PeeJay/MotionBoard/README.md

# MotionBoard
FirePick Delta/Ramps compatible motion controller running Smoothie
