PeeJay/MotionBoard/MotionBoard Rev C.pdf

## UART0 (Also for ISP Loading)

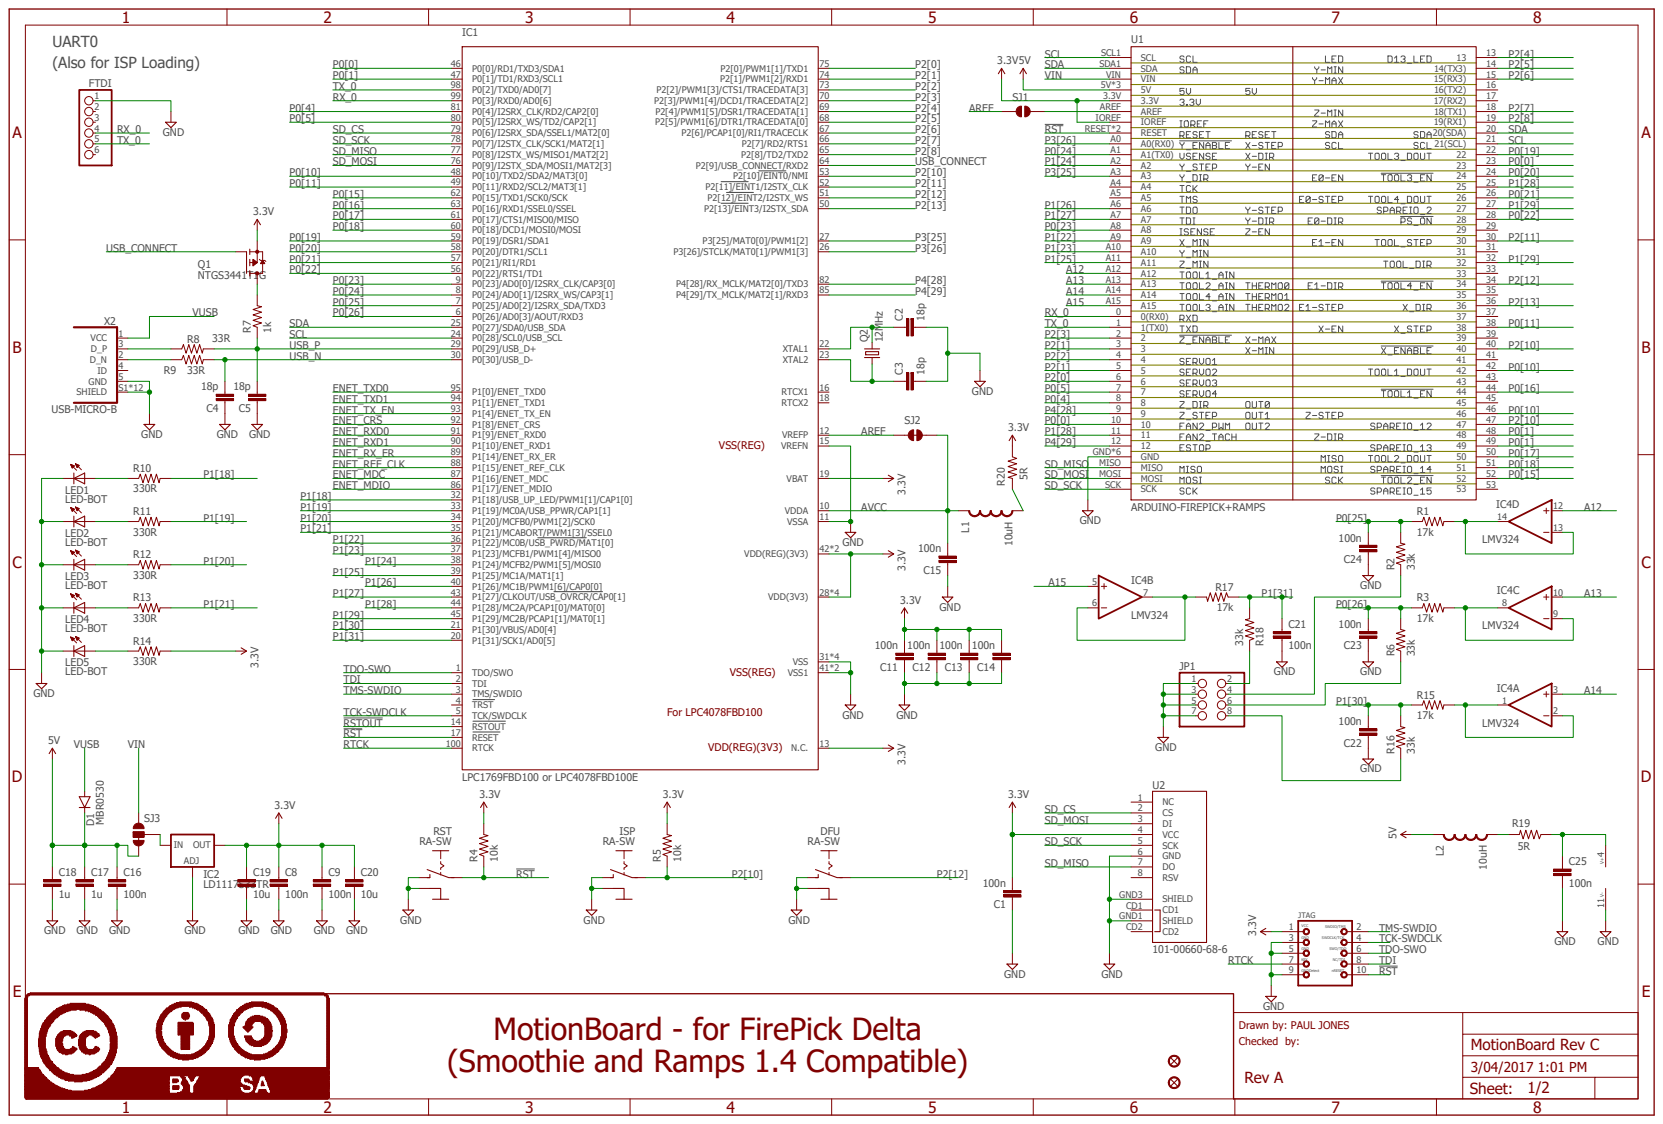
[picture p1: page 1]

RESET RESET*2 A0(RX0) A0 | | 21 20(SDA) 20 19(RX1) 19 SDA

IOREF | | P2[8]

21(SCL)

A4 A4 | 25 26 | 25 P1[28]
A5 A5 | | 26 P0[21]

0(RX0) 0 | 37 | 37 38 P0[11]
1(TX0) 1 2 2 | 38

GND
Drawn by: PAUL JONES
Checked by:
Rev A

MotionBoard - for FirePick Delta

# GND GND RD+ RD+ P5 P5

A

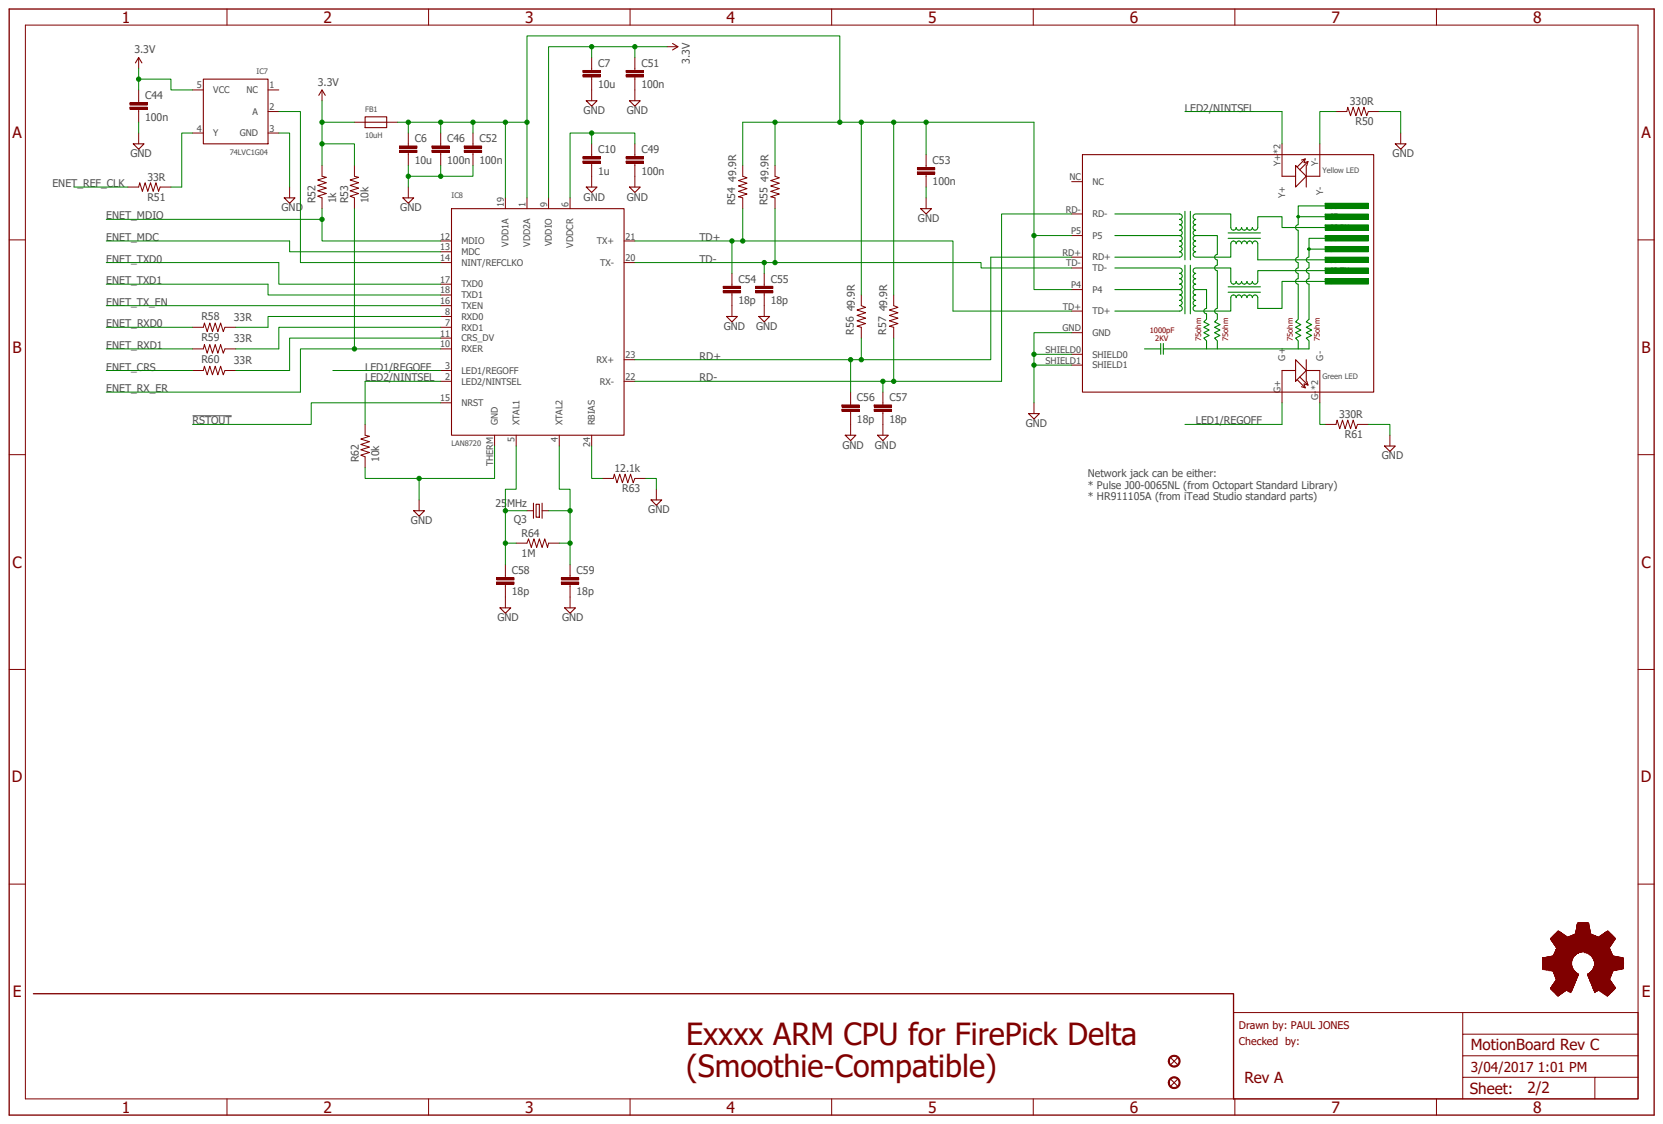
[picture p2: page 2]

Network jack can be either:
* Pulse J00‑0065NL (from Octopart Standard Library)
* HR911105A (from iTead Studio standard parts)

Exxxx ARM CPU for FirePick Delta
(Smoothie-Compatible)

Drawn by: PAUL JONES
Checked by:
Rev A
