PeeJay/MotionBoard/MotionBoard Rev C Layout.pdf

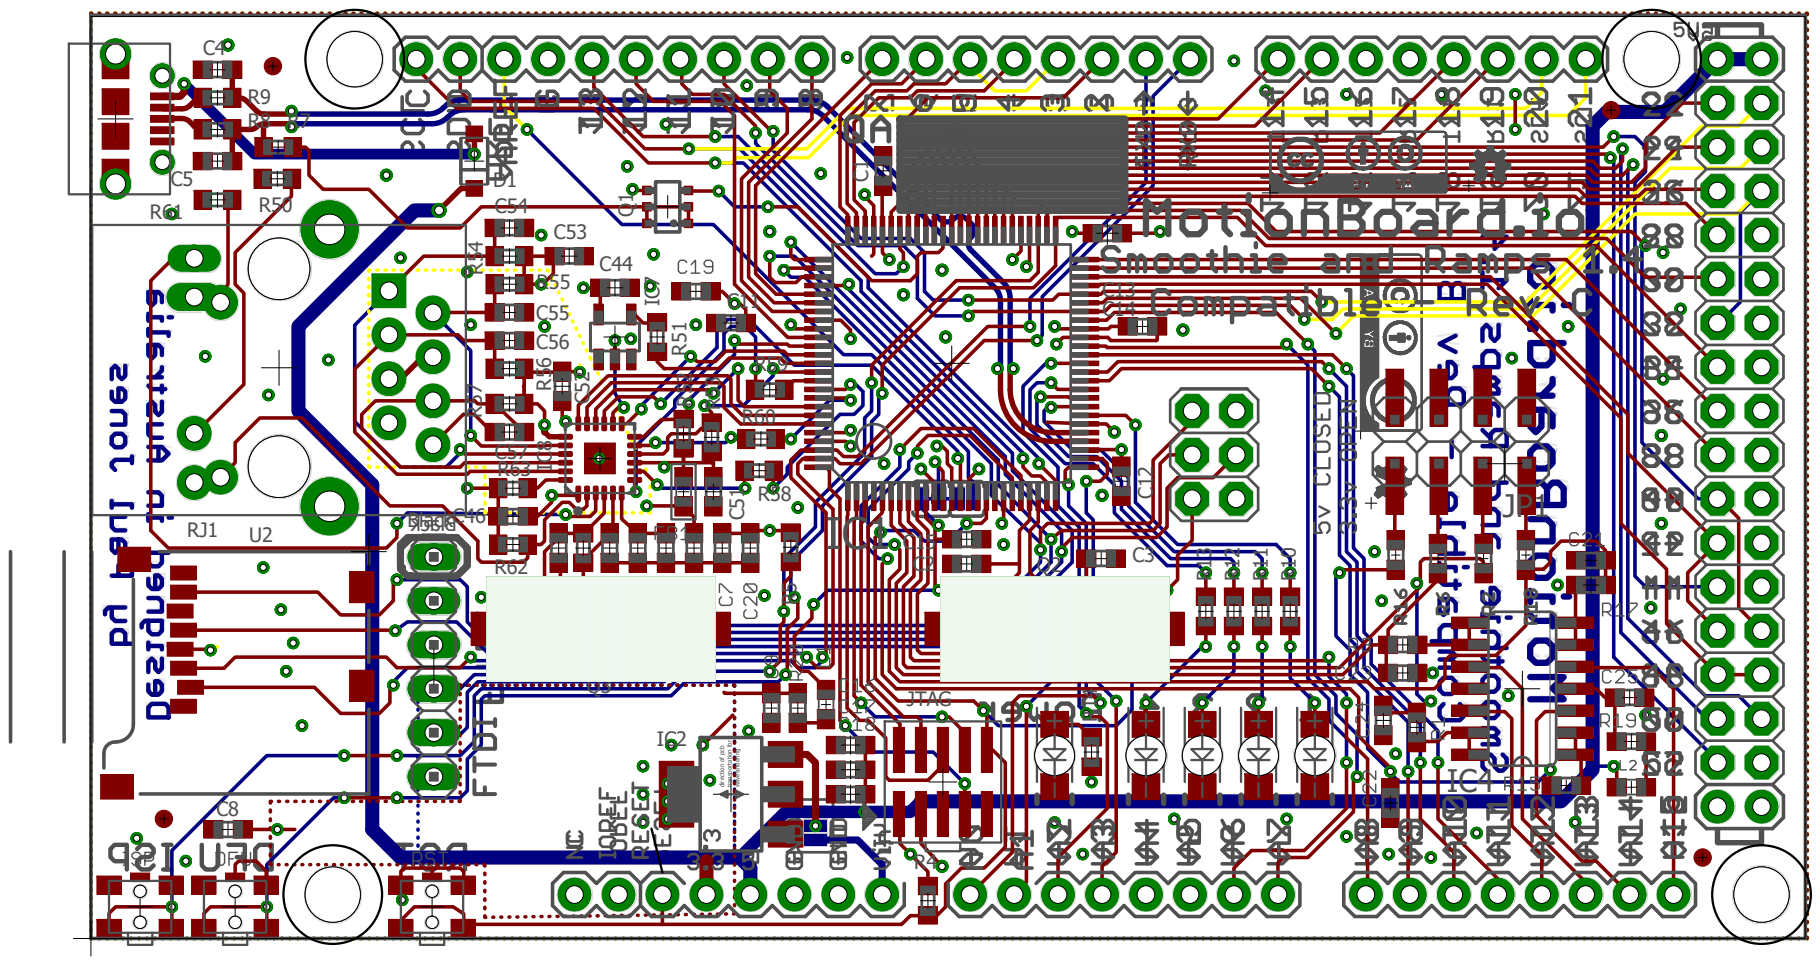
[picture p3: page 1]
