PeeJay/MotionBoard/MotionBoard Rev B.pdf

## UART0 (Also for ISP Loading)

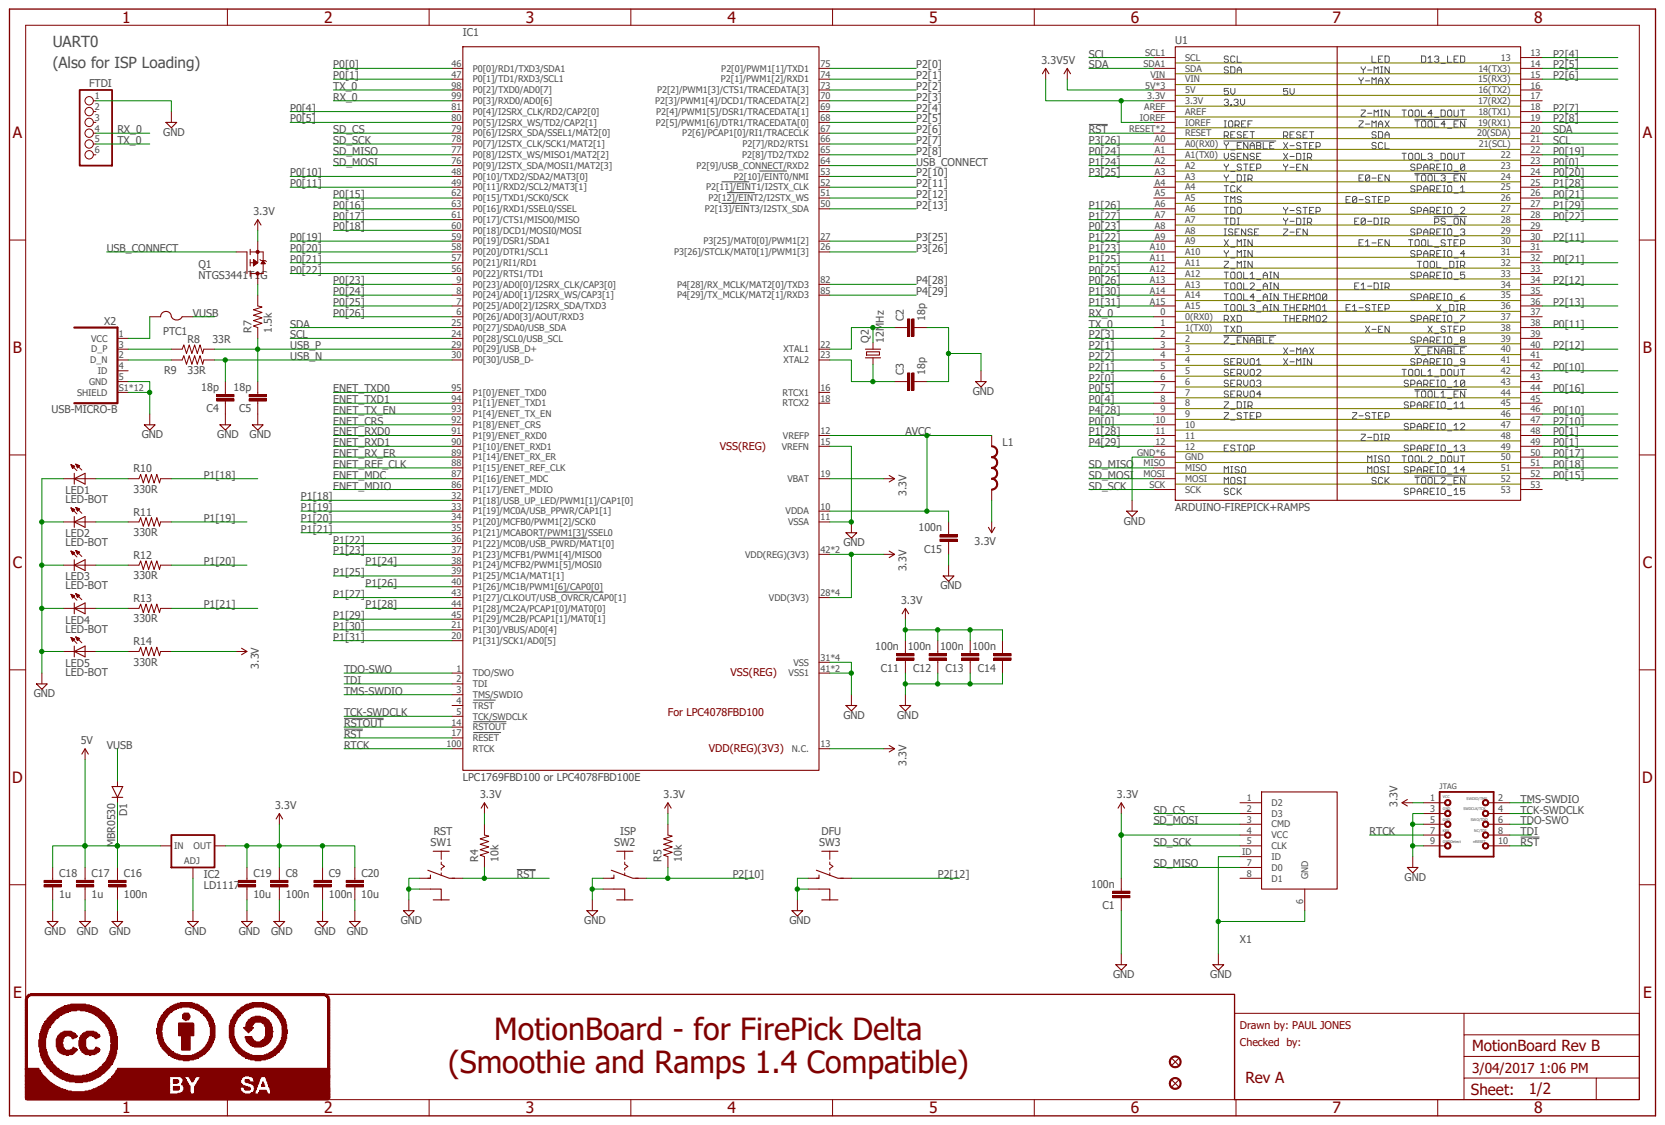
[picture p4: page 1]

VIN
5V 5V*3 3.3V 3.3V

AREF
IOREF

A2 A2
A3 A3 A4 A4

A7 A7
A8 A8 A9 A9

A12
A13 A13 A14 A14

1(TX0) 1
2 2 3 3

6 6
7 7 8 8

48 | 48 11 11
12 12 GND GND*6

MISO MISO MOSI MOSI

SCK

MotionBoard - for FirePick Delta

Drawn by: PAUL JONES
Checked by:
Rev A

A

A

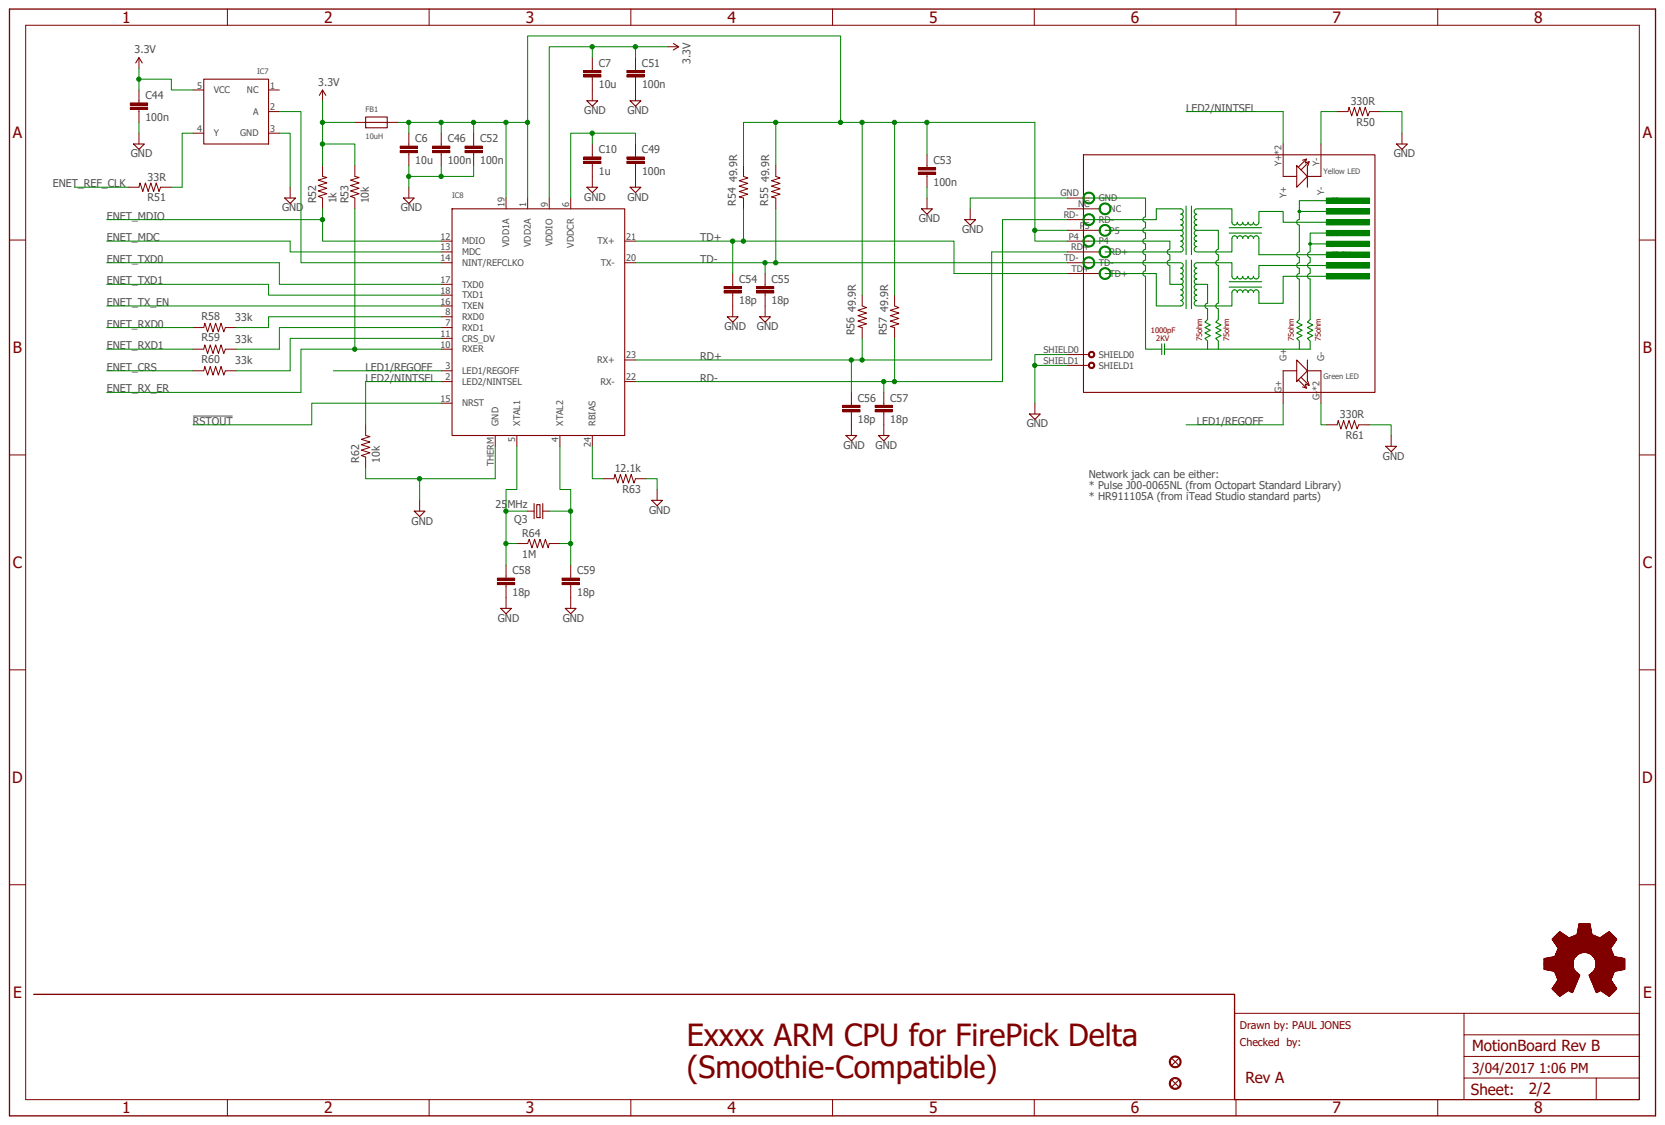
[picture p5: page 2]

Network jack can be either:
* Pulse J00‑0065NL (from Octopart Standard Library)
* HR911105A (from iTead Studio standard parts)

Exxxx ARM CPU for FirePick Delta
(Smoothie-Compatible)

Drawn by: PAUL JONES
Checked by:
Rev A
