PeeJay/MotionBoard/MotionBoard Rev B Layout.pdf

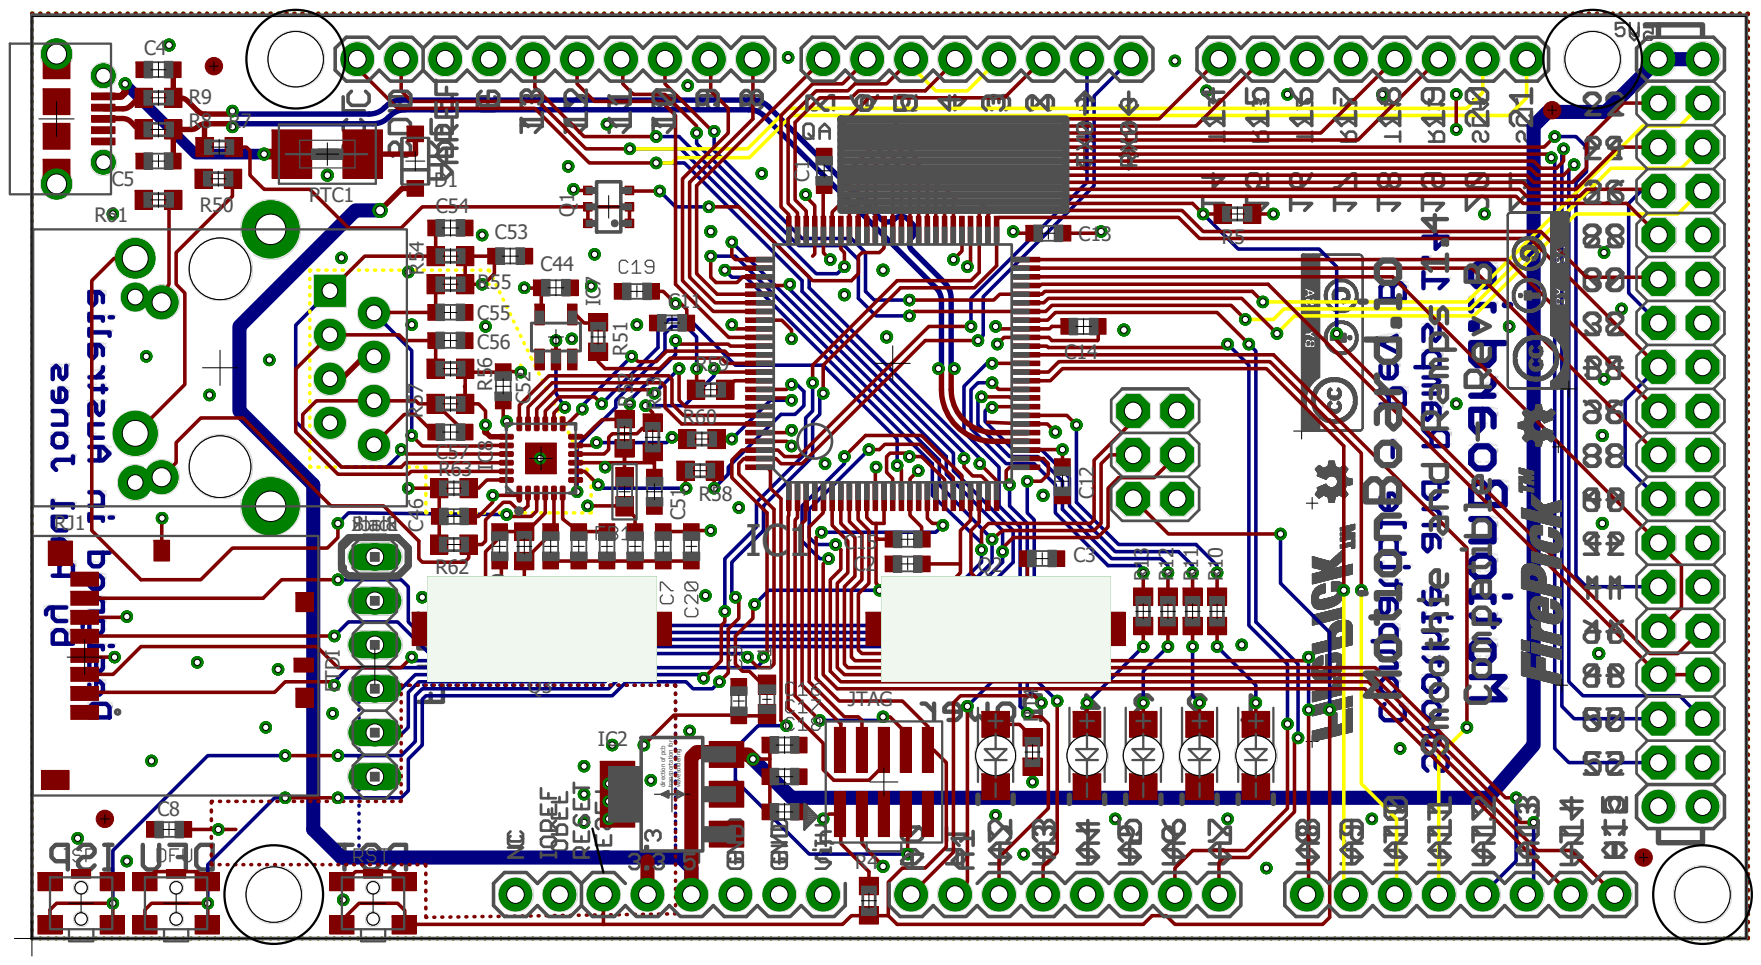
[picture p6: page 1]
