PeeJay/MotionBoard/EARM01.brd

## EAGLE design EARM01.brd (2015-06-06)

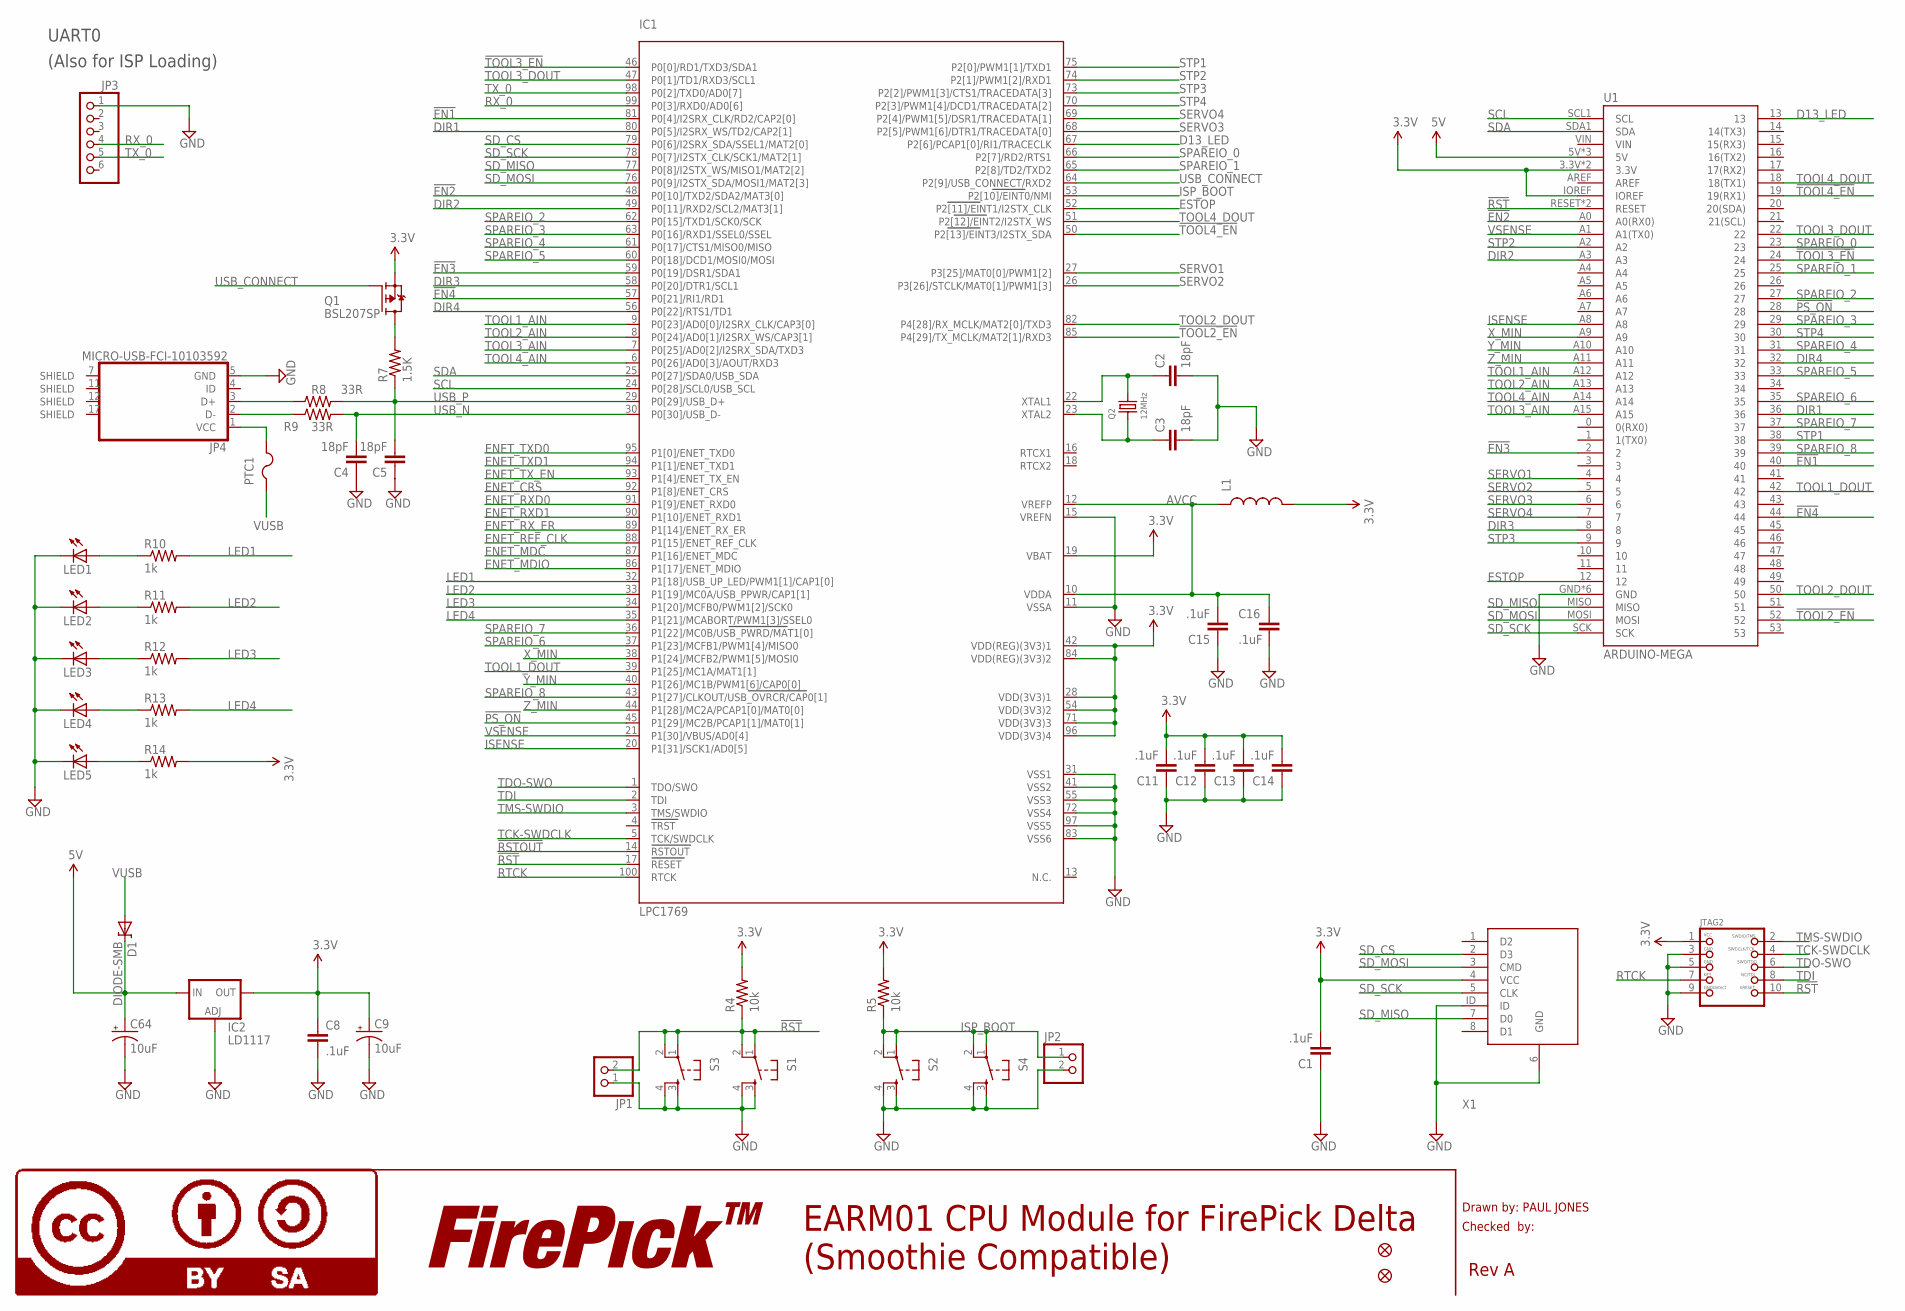
[picture p11: schematic EARM01.sch, sheet 1]

Parts:
C1, C8, C11, C12, C13, C14, C15, C16: .1uF; C0603
C2, C3, C4, C5: 18pF; C0603
C9, C64: 10uF; EIA3216
D1: DIODE-SMB; SMB-DIODE
FID5, FID6: FIDUCIAL1X2; FIDUCIAL-1X2
IC1: LPC1769; LQFP100
IC2: LD1117; SOT223
JP1, JP2: PINHD-1X2; 1X02
JP3: PINHD-1X6; 1X06
JP4: MICRO-USB-FCI-10103592
JTAG2: JTAG-CORTEXM3; 2X05_1.27MM_SMT
L1: INDUCTOR0603; 0603
LED1, LED2, LED3, LED4, LED5: LED; LED-1206-BOTTOM
LOGO4: LOGO-FIREPICKMEDIUM; LOGO-FIREPICK-MEDIUM
LOGO6: LOGO-CC-BY-SAMEDIUM; LOGO-CC-BY-SA-MEDIUM
PTC1: PTCFUSE-1812; 1812
Q1: BSL207SP; SC74_INFINEON
Q2: 12MHz; CRYSTAL_3.2X2.5
R4, R5: 10k; R0603
R7: 1.5K; R0603
R8, R9: 33R; R0603
R10, R11, R12, R13, R14: 1k; R0603
S1, S2, S3, S4: TAC_SWITCHSMD; TACTILE_SWITCH_SMD
U1: ARDUINO-MEGA; ARDUINO_MEGA_NEW
X1: ST9S008V4AR1500

Connections:
3.3V: C1.2, C8.1, C9.A (+), C11.2, C12.2, C13.2, C14.2, IC1.19 (VBAT), IC1.28 (VDD(3V3)1), IC1.42 (VDD(REG)(3V3)1), IC1.54 (VDD(3V3)2), IC1.71 (VDD(3V3)3), IC1.84 (VDD(REG)(3V3)2), IC1.96 (VDD(3V3)4), IC2.4 (OUT), JTAG2.1, L1.2, Q1.4 (S), R4.2, R5.2, R14.2, U1.3.3V, U1.IOREF, U1.VCC (3.3V), X1.4 (VCC); also elsewhere on the board
5V: C64.A (+), D1.C, IC2.3 (IN), U1.5V, U1.5V@1 (5V), U1.5V@2 (5V)
!EN1: IC1.81 (P0[4]/I2SRX_CLK/RD2/CAP2[0]), U1.40
!EN2: IC1.48 (P0[10]/TXD2/SDA2/MAT3[0]), U1.A0 (A0(RX0))
!EN3: IC1.59 (P0[19]/DSR1/SDA1), U1.2
!EN4: IC1.57 (P0[21]/RI1/RD1), U1.44
!PS_ON: IC1.45 (P1[29]/MC2B/PCAP1[1]/MAT0[1]), U1.28
!RST: IC1.17 (RESET), JP1.2, JTAG2.10, R4.1, S1.1, S1.2, S3.1, S3.2, U1.RESET, U1.RST (RESET)
!RSTOUT: IC1.14 (RSTOUT); also elsewhere on the board
!TOOL2_EN: IC1.85 (P4[29]/TX_MCLK/MAT2[1]/RXD3), U1.52
!TOOL3_EN: IC1.46 (P0[0]/RD1/TXD3/SDA1), U1.24
!TOOL4_EN: IC1.50 (P2[13]/EINT3/I2STX_SDA), U1.19 (19(RX1))
AVCC: C15.2, C16.1, IC1.10 (VDDA), IC1.12 (VREFP), L1.1
D13_LED: IC1.67 (P2[6]/PCAP1[0]/RI1/TRACECLK), U1.13
DIR1: IC1.80 (P0[5]/I2SRX_WS/TD2/CAP2[1]), U1.36
DIR2: IC1.49 (P0[11]/RXD2/SCL2/MAT3[1]), U1.A3
DIR3: IC1.58 (P0[20]/DTR1/SCL1), U1.8
DIR4: IC1.56 (P0[22]/RTS1/TD1), U1.32
ENET_CRS: IC1.92 (P1[8]/ENET_CRS); also elsewhere on the board
ENET_MDC: IC1.87 (P1[16]/ENET_MDC); also elsewhere on the board
ENET_MDIO: IC1.86 (P1[17]/ENET_MDIO); also elsewhere on the board
ENET_REF_CLK: IC1.88 (P1[15]/ENET_REF_CLK); also elsewhere on the board
ENET_RXD0: IC1.91 (P1[9]/ENET_RXD0); also elsewhere on the board
ENET_RXD1: IC1.90 (P1[10]/ENET_RXD1); also elsewhere on the board
ENET_RX_ER: IC1.89 (P1[14]/ENET_RX_ER); also elsewhere on the board
ENET_TXD0: IC1.95 (P1[0]/ENET_TXD0); also elsewhere on the board
ENET_TXD1: IC1.94 (P1[1]/ENET_TXD1); also elsewhere on the board
ENET_TX_EN: IC1.93 (P1[4]/ENET_TX_EN); also elsewhere on the board
ESTOP: IC1.52 (P2[11]/EINT1/I2STX_CLK), U1.12
GND: C1.1, C2.2, C3.2, C4.1, C5.1, C8.2, C9.C (-), C11.1, C12.1, C13.1, C14.1, C15.1, C16.2, C64.C (-), IC1.11 (VSSA), IC1.15 (VREFN), IC1.31 (VSS1), IC1.41 (VSS2), IC1.55 (VSS3), IC1.72 (VSS4), IC1.83 (VSS6), IC1.97 (VSS5), IC2.1 (ADJ), JP1.1, JP2.2, JP3.1, JP4.5 (GND), JTAG2.3, JTAG2.5, JTAG2.9, LED1.C, LED2.C, LED3.C, LED4.C, LED5.C, S1.3, S1.4, S2.3, S2.4, S3.3, S3.4, S4.3, S4.4, U1.GND, U1.GND@0 (GND), U1.GND@1 (GND), U1.GND@2 (GND), U1.GND@3 (GND), U1.GNDI (GND), X1.6 (GND), X1.ID; also elsewhere on the board
ISENSE: IC1.20 (P1[31]/SCK1/AD0[5]), U1.A8
ISP_BOOT: IC1.53 (P2[10]/EINT0/NMI), JP2.1, R5.1, S2.1, S2.2, S4.1, S4.2
LED1: IC1.32 (P1[18]/USB_UP_LED/PWM1[1]/CAP1[0]), R10.2
LED2: IC1.33 (P1[19]/MC0A/USB_PPWR/CAP1[1]), R11.2
LED3: IC1.34 (P1[20]/MCFB0/PWM1[2]/SCK0), R12.2
LED4: IC1.35 (P1[21]/MCABORT/PWM1[3]/SSEL0), R13.2
unnamed: C2.1, IC1.22 (XTAL1), Q2.2
unnamed: C3.1, IC1.23 (XTAL2), Q2.1
unnamed: JP4.1 (VCC), PTC1.2
unnamed: Q1.1 (D), Q1.2 (D), Q1.5 (D), Q1.6 (D), R7.2
unnamed: JP4.3 (D+), R8.1
unnamed: JP4.2 (D-), R9.1
unnamed: LED5.A, R14.1
unnamed: LED4.A, R13.1
unnamed: LED3.A, R12.1
unnamed: LED2.A, R11.1
unnamed: LED1.A, R10.1
RTCK: IC1.100 (RTCK), JTAG2.7
RX_0: IC1.99 (P0[3]/RXD0/AD0[6]), JP3.4
SCL: IC1.24 (P0[28]/SCL0/USB_SCL), U1.SCL1 (SCL)
SDA: IC1.25 (P0[27]/SDA0/USB_SDA), U1.SDA1 (SDA)
SD_CS: IC1.79 (P0[6]/I2SRX_SDA/SSEL1/MAT2[0]), X1.2 (D3)
SD_MISO: IC1.77 (P0[8]/I2STX_WS/MISO1/MAT2[2]), U1.MISO, X1.7 (D0)
SD_MOSI: IC1.76 (P0[9]/I2STX_SDA/MOSI1/MAT2[3]), U1.MOSI, X1.3 (CMD)
SD_SCK: IC1.78 (P0[7]/I2STX_CLK/SCK1/MAT2[1]), U1.SCK, X1.5 (CLK)
SERVO1: IC1.27 (P3[25]/MAT0[0]/PWM1[2]), U1.4
SERVO2: IC1.26 (P3[26]/STCLK/MAT0[1]/PWM1[3]), U1.5
SERVO3: IC1.68 (P2[5]/PWM1[6]/DTR1/TRACEDATA[0]), U1.6
SERVO4: IC1.69 (P2[4]/PWM1[5]/DSR1/TRACEDATA[1]), U1.7
SPAREIO_0: IC1.66 (P2[7]/RD2/RTS1), U1.23
SPAREIO_1: IC1.65 (P2[8]/TD2/TXD2), U1.25
SPAREIO_2: IC1.62 (P0[15]/TXD1/SCK0/SCK), U1.27
SPAREIO_3: IC1.63 (P0[16]/RXD1/SSEL0/SSEL), U1.29
SPAREIO_4: IC1.61 (P0[17]/CTS1/MISO0/MISO), U1.31
SPAREIO_5: IC1.60 (P0[18]/DCD1/MOSI0/MOSI), U1.33
SPAREIO_6: IC1.37 (P1[23]/MCFB1/PWM1[4]/MISO0), U1.35
SPAREIO_7: IC1.36 (P1[22]/MC0B/USB_PWRD/MAT1[0]), U1.37
SPAREIO_8: IC1.43 (P1[27]/CLKOUT/USB_OVRCR/CAP0[1]), U1.39
STP1: IC1.75 (P2[0]/PWM1[1]/TXD1), U1.38
STP2: IC1.74 (P2[1]/PWM1[2]/RXD1), U1.A2
STP3: IC1.73 (P2[2]/PWM1[3]/CTS1/TRACEDATA[3]), U1.9
STP4: IC1.70 (P2[3]/PWM1[4]/DCD1/TRACEDATA[2]), U1.30
TCK-SWDCLK: IC1.5 (TCK/SWDCLK), JTAG2.4
TDI: IC1.2 (TDI), JTAG2.8
TDO-SWO: IC1.1 (TDO/SWO), JTAG2.6
TMS-SWDIO: IC1.3 (TMS/SWDIO), JTAG2.2
TOOL1_AIN: IC1.9 (P0[23]/AD0[0]/I2SRX_CLK/CAP3[0]), U1.A12
TOOL1_DOUT: IC1.39 (P1[25]/MC1A/MAT1[1]), U1.42
TOOL2_AIN: IC1.8 (P0[24]/AD0[1]/I2SRX_WS/CAP3[1]), U1.A13
TOOL2_DOUT: IC1.82 (P4[28]/RX_MCLK/MAT2[0]/TXD3), U1.50
TOOL3_AIN: IC1.7 (P0[25]/AD0[2]/I2SRX_SDA/TXD3), U1.A15
TOOL3_DOUT: IC1.47 (P0[1]/TD1/RXD3/SCL1), U1.22
TOOL4_AIN: IC1.6 (P0[26]/AD0[3]/AOUT/RXD3), U1.A14
TOOL4_DOUT: IC1.51 (P2[12]/EINT2/I2STX_WS), U1.18 (18(TX1))
TX_0: IC1.98 (P0[2]/TXD0/AD0[7]), JP3.5
USB_CONNECT: IC1.64 (P2[9]/USB_CONNECT/RXD2), Q1.3 (G)
USB_N: C4.2, IC1.30 (P0[30]/USB_D-), R9.2
USB_P: C5.2, IC1.29 (P0[29]/USB_D+), R7.1, R8.2
VSENSE: IC1.21 (P1[30]/VBUS/AD0[4]), U1.A1 (A1(TX0))
VUSB: D1.A, PTC1.1
X_MIN: IC1.38 (P1[24]/MCFB2/PWM1[5]/MOSI0), U1.A9
Y_MIN: IC1.40 (P1[26]/MC1B/PWM1[6]/CAP0[0]), U1.A10
Z_MIN: IC1.44 (P1[28]/MC2A/PCAP1[0]/MAT0[0]), U1.A11

Notes on the sheet:
Drawn by: PAUL JONES
Checked by:
Rev A
EARM01 CPU Module for FirePick Delta (Smoothie Compatible)
UART0
(Also for ISP Loading)
