PeeJay/MotionBoard/EARM01.brd

## EAGLE design EARM01.brd (continued)

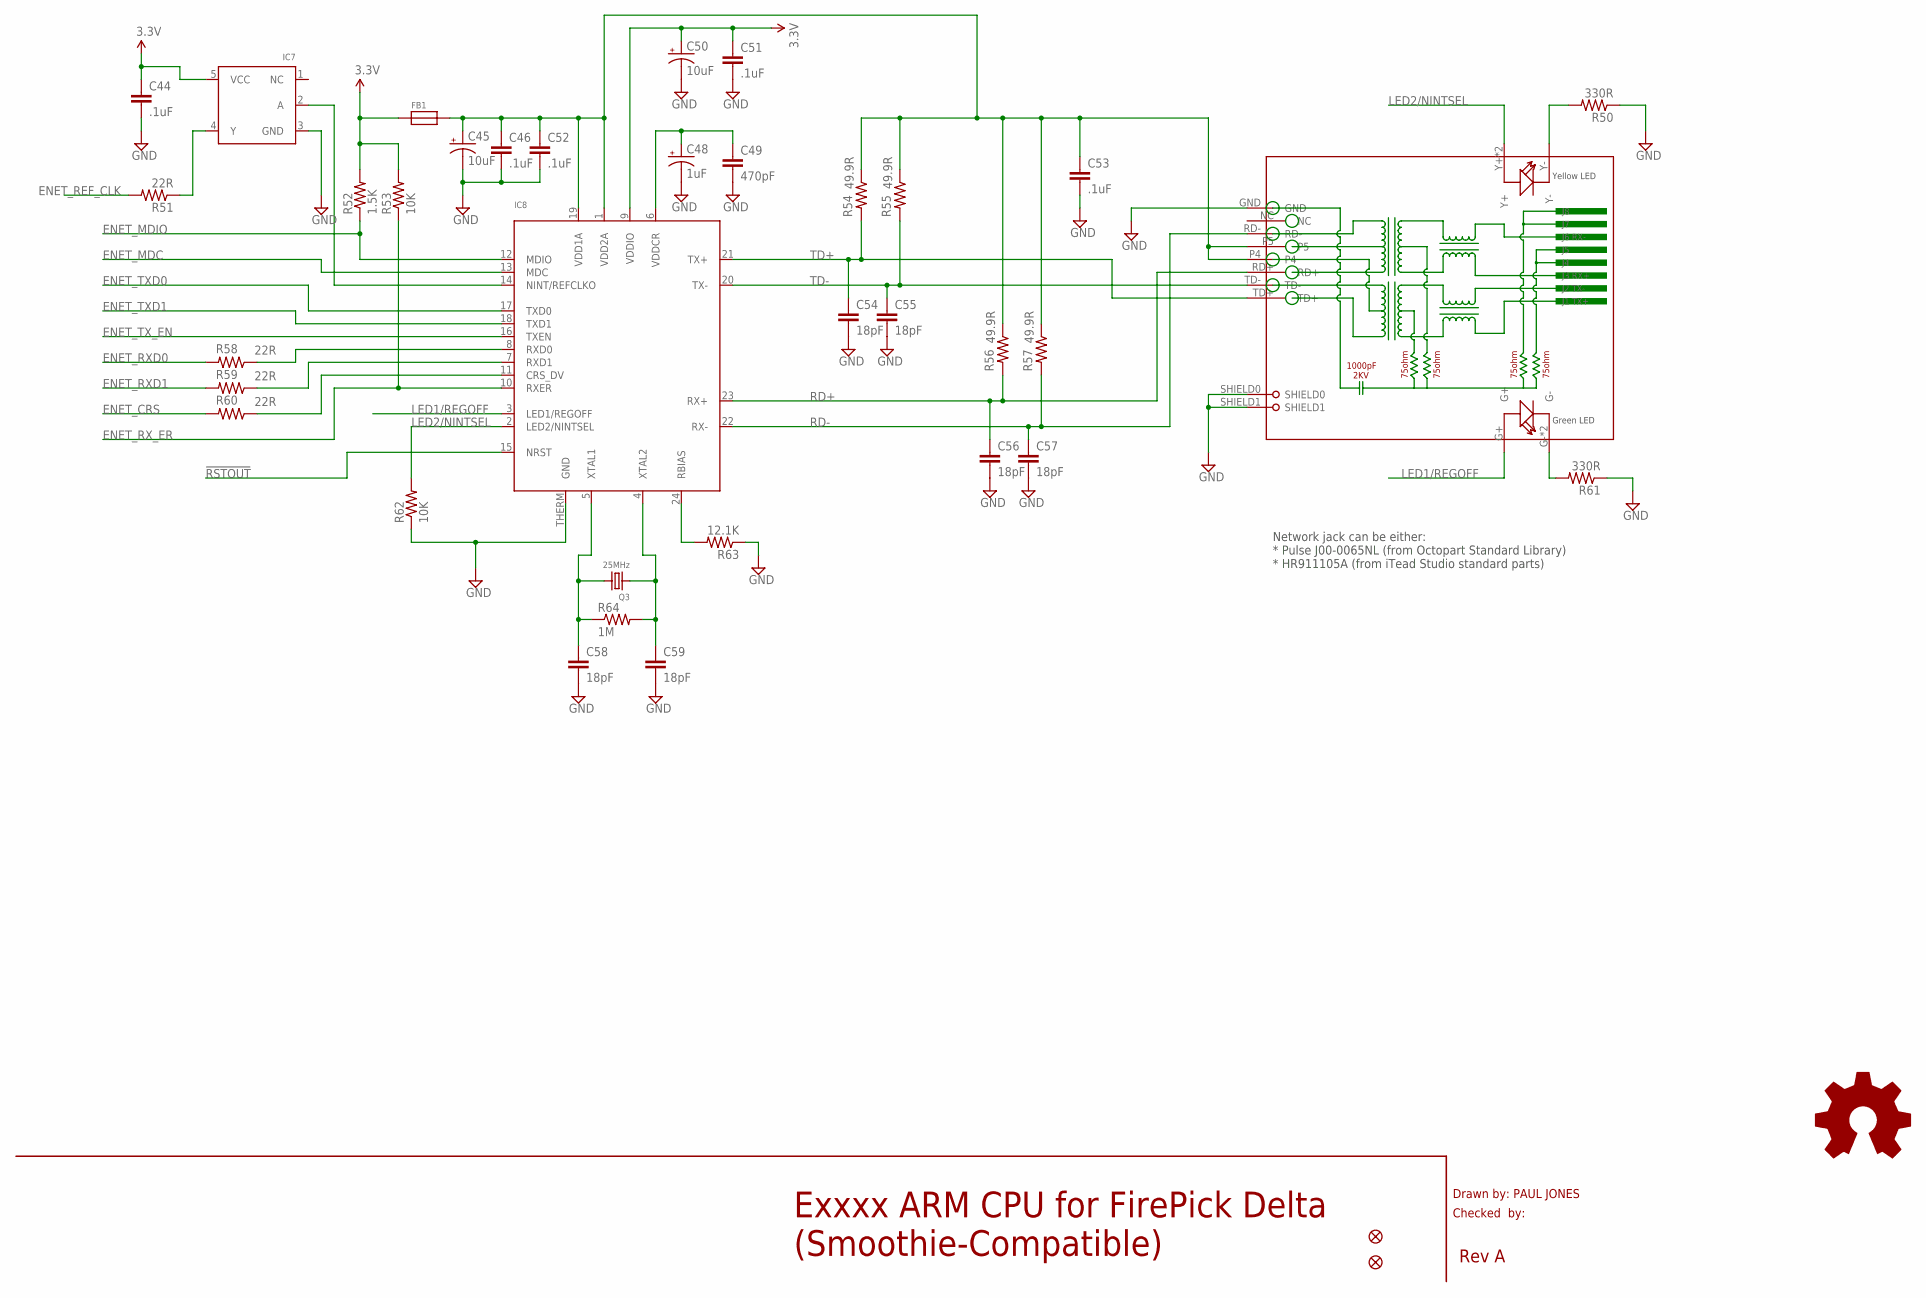
[picture p12: schematic EARM01.sch, sheet 2]

Parts:
C44, C46, C51, C52, C53: .1uF; C0603
C45, C50: 10uF; EIA3216
C48: 1uF; EIA3216
C49: 470pF; C0603K
C54, C55, C56, C57, C58, C59: 18pF; C0603
FB1: FERRITE; 0603
FID17, FID18: FIDUCIAL1X2; FIDUCIAL-1X2
IC7: 74LVC1G04; SOT23-5
IC8: LAN8720; QFN24_4MM
LOGO10: LOGO-OSHWSMALL; LOGO-OSHW-SMALL
Q3: 25MHz; CRYSTAL_3.2X2.5
R50, R61: 330R; R0603
R51, R58, R59, R60: 22R; R0603
R52: 1.5K; R0603
R53, R62: 10K; R0603
R54, R55, R56, R57: 49.9R; R0603
R63: 12.1K; R0603
R64: 1M; R0603
RJ1: HR911105A

Connections:
3.3V: C44.1, C50.A (+), C51.1, FB1.1, IC7.5 (VCC), IC8.9 (VDDIO), R52.2, R53.2; also elsewhere on the board
!RSTOUT: IC8.15 (NRST); also elsewhere on the board
ENET_CRS: R60.2; also elsewhere on the board
ENET_MDC: IC8.13 (MDC); also elsewhere on the board
ENET_MDIO: IC8.12 (MDIO), R52.1; also elsewhere on the board
ENET_REF_CLK: R51.2; also elsewhere on the board
ENET_RXD0: R58.2; also elsewhere on the board
ENET_RXD1: R59.2; also elsewhere on the board
ENET_RX_ER: IC8.10 (RXER), R53.1; also elsewhere on the board
ENET_TXD0: IC8.17 (TXD0); also elsewhere on the board
ENET_TXD1: IC8.18 (TXD1); also elsewhere on the board
ENET_TX_EN: IC8.16 (TXEN); also elsewhere on the board
GND: C44.2, C45.C (-), C46.2, C48.C (-), C49.2, C50.C (-), C51.2, C52.2, C53.2, C54.2, C55.2, C56.2, C57.2, C58.2, C59.2, IC7.3 (GND), IC8.THERM (GND), R50.1, R61.1, R62.1, R63.1, RJ1.GND, RJ1.SHIELD0, RJ1.SHIELD1; also elsewhere on the board
LED1/REGOFF: IC8.3 (LED1/REGOFF), RJ1.G+
LED2/NINTSEL: IC8.2 (LED2/NINTSEL), R62.2, RJ1.Y+, RJ1.Y++ (Y+)
unnamed: IC8.11 (CRS_DV), R60.1
unnamed: IC8.24 (RBIAS), R63.2
unnamed: C48.A (+), C49.1, IC8.6 (VDDCR)
unnamed: IC7.2 (A), IC8.14 (NINT/REFCLKO)
unnamed: R61.2, RJ1.G-, RJ1.G-- (G-)
unnamed: IC8.8 (RXD0), R58.1
unnamed: R50.2, RJ1.Y-
unnamed: IC8.7 (RXD1), R59.1
unnamed: C59.1, IC8.4 (XTAL2), Q3.1, R64.2
unnamed: C58.1, IC8.5 (XTAL1), Q3.2, R64.1
unnamed: IC7.4 (Y), R51.1
RD+: C56.1, IC8.23 (RX+), R56.2, RJ1.RD+
RD-: C57.1, IC8.22 (RX-), R57.2, RJ1.RD-
TD+: C54.1, IC8.21 (TX+), R54.2, RJ1.TD+
TD-: C55.1, IC8.20 (TX-), R55.2, RJ1.TD-
VDD: C45.A (+), C46.1, C52.1, C53.1, FB1.2, IC8.1 (VDD2A), IC8.19 (VDD1A), R54.1, R55.1, R56.1, R57.1, RJ1.P4, RJ1.P5

Notes on the sheet:
Drawn by: PAUL JONES
Checked by:
Rev A
Exxxx ARM CPU for FirePick Delta (Smoothie-Compatible)
Network jack can be either: * Pulse J00‑0065NL (from Octopart Standard Library) * HR911105A (from iTead Studio standard parts)

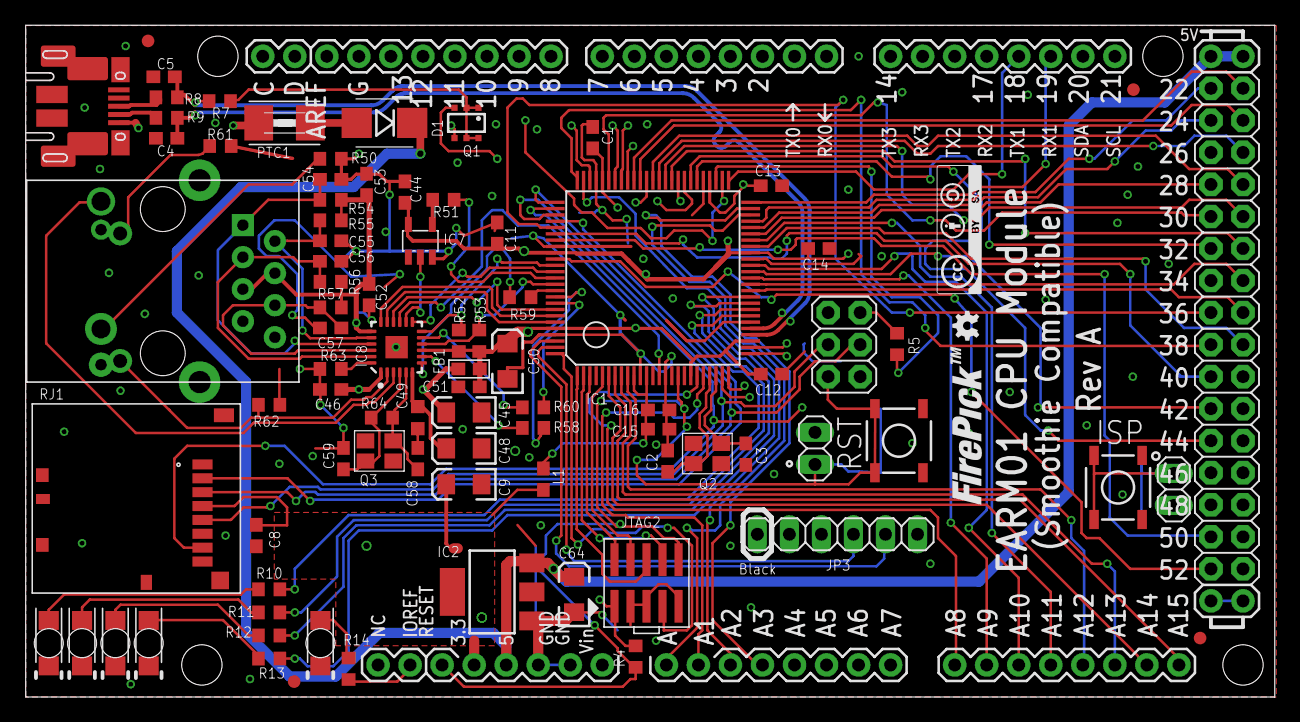
[picture p13: board EARM01.brd from above]

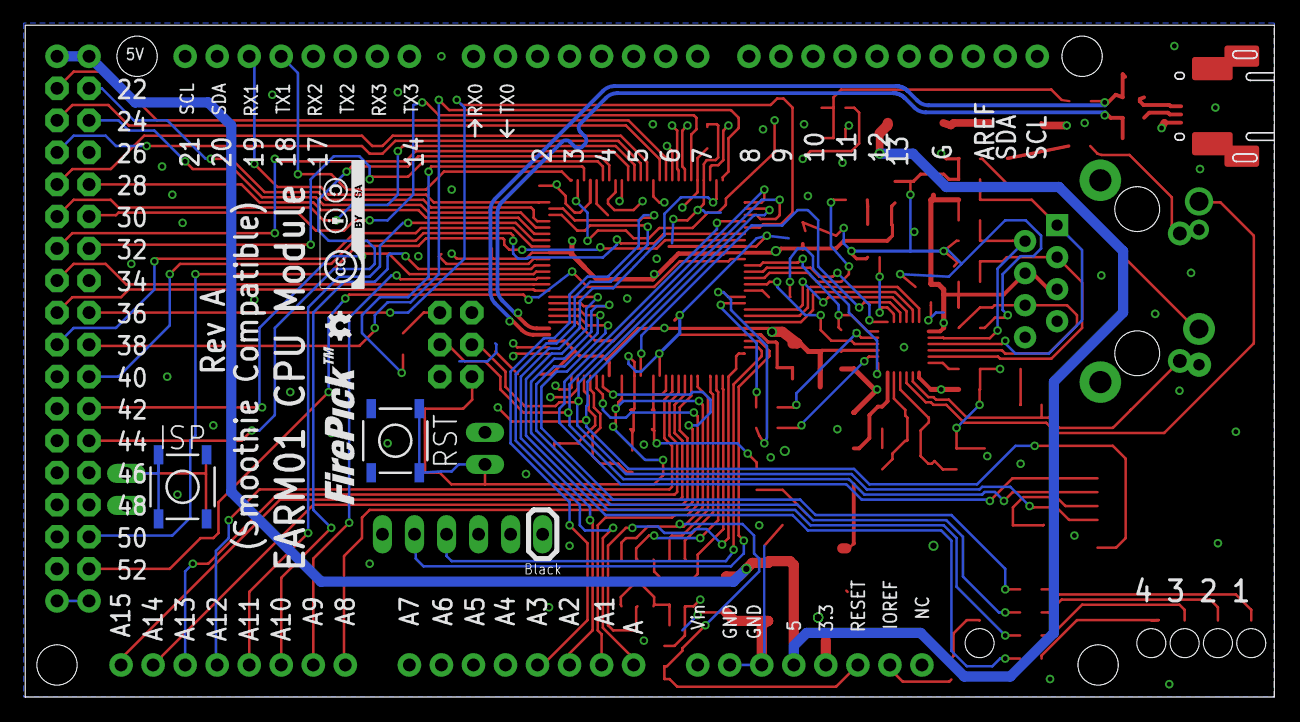
[picture p14: board EARM01.brd from below]

Board: 4 copper layers, 99.0 x 53.3 mm, 92 parts (5 on the bottom side), 111 nets.

Other parts of the board:
LOGO1: LOGO-FIREPICKMEDIUM; LOGO-FIREPICK-MEDIUM
LOGO2: LOGO-OSHWSMALL; LOGO-OSHW-SMALL
LOGO3: LOGO-CC-BY-SAMEDIUM; LOGO-CC-BY-SA-MEDIUM
