PeeJay/MotionBoard/(commit log)

2015-06-06 Add board files
    [EARM01 Rev B.brd, EARM01 Rev B.sch, EARM01.brd, EARM01.sch]
2015-06-09 Update board files
    [MotionBoard Rev B.brd, MotionBoard Rev B.sch]
2015-06-12 Cosmetic changes
    Add new name to schematic and rearrange page 1 so it all fits on the
    page
    [MotionBoard Rev B.brd, MotionBoard Rev B.sch]
2015-06-28 Update with production files
    Also note a "whoopsie" where wire jumpers are required...
    [MotionBoard Rev B.brd, MotionBoard Rev B.sch]
2015-09-29 Add rev C board
    * Fix misrouted Arduino pins
    * Replace obsolete Micro SD Card
    * Add analog input buffering + 5v voltage divider
    * Add solder jumpers to AREF and VIN
    * Add extra filtering to AREF and analog inputs
    [MotionBoard Rev C.brd, MotionBoard Rev C.sch]
2016-01-11 Update component values
    [MotionBoard Rev B.brd, MotionBoard Rev C-old-sd.brd, MotionBoard Rev C-old-sd.sch, MotionBoard Rev C.sch]
2016-01-11 Forgot to update resistor divider values
    [MotionBoard Rev C.brd, MotionBoard Rev C.sch]
